Butterest/Blue-Skies-Test-Drone/DronePCB/DronePCB.kicad_pcb

## KiCad design DronePCB/DronePCB.kicad_pcb (2026-11-14)

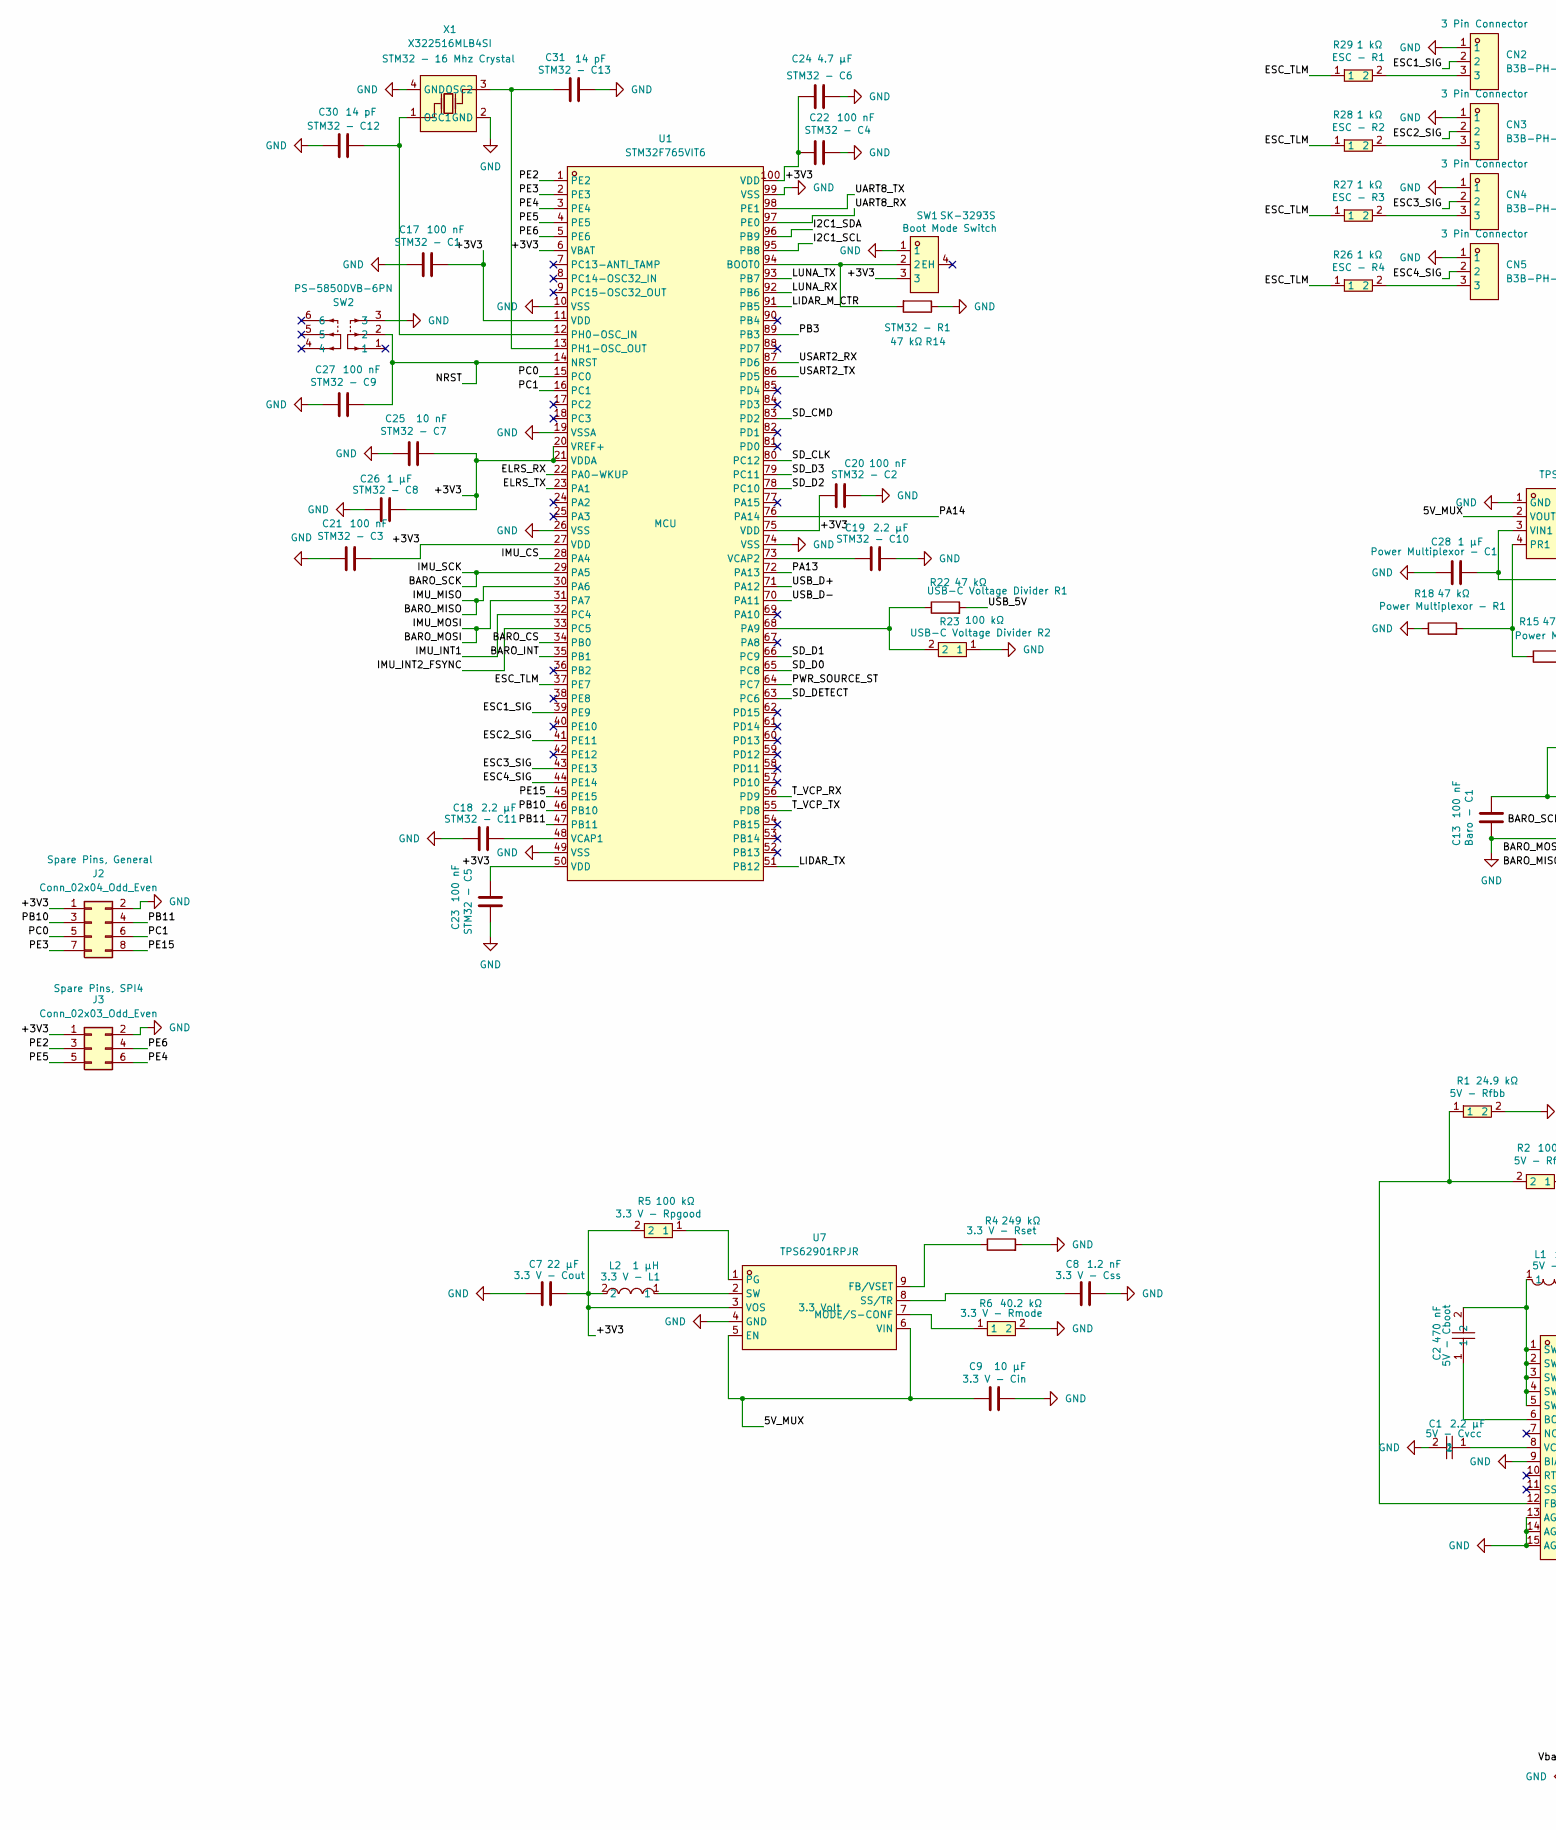
[picture p1: schematic DronePCB.kicad_sch, part in row 1, column 1]

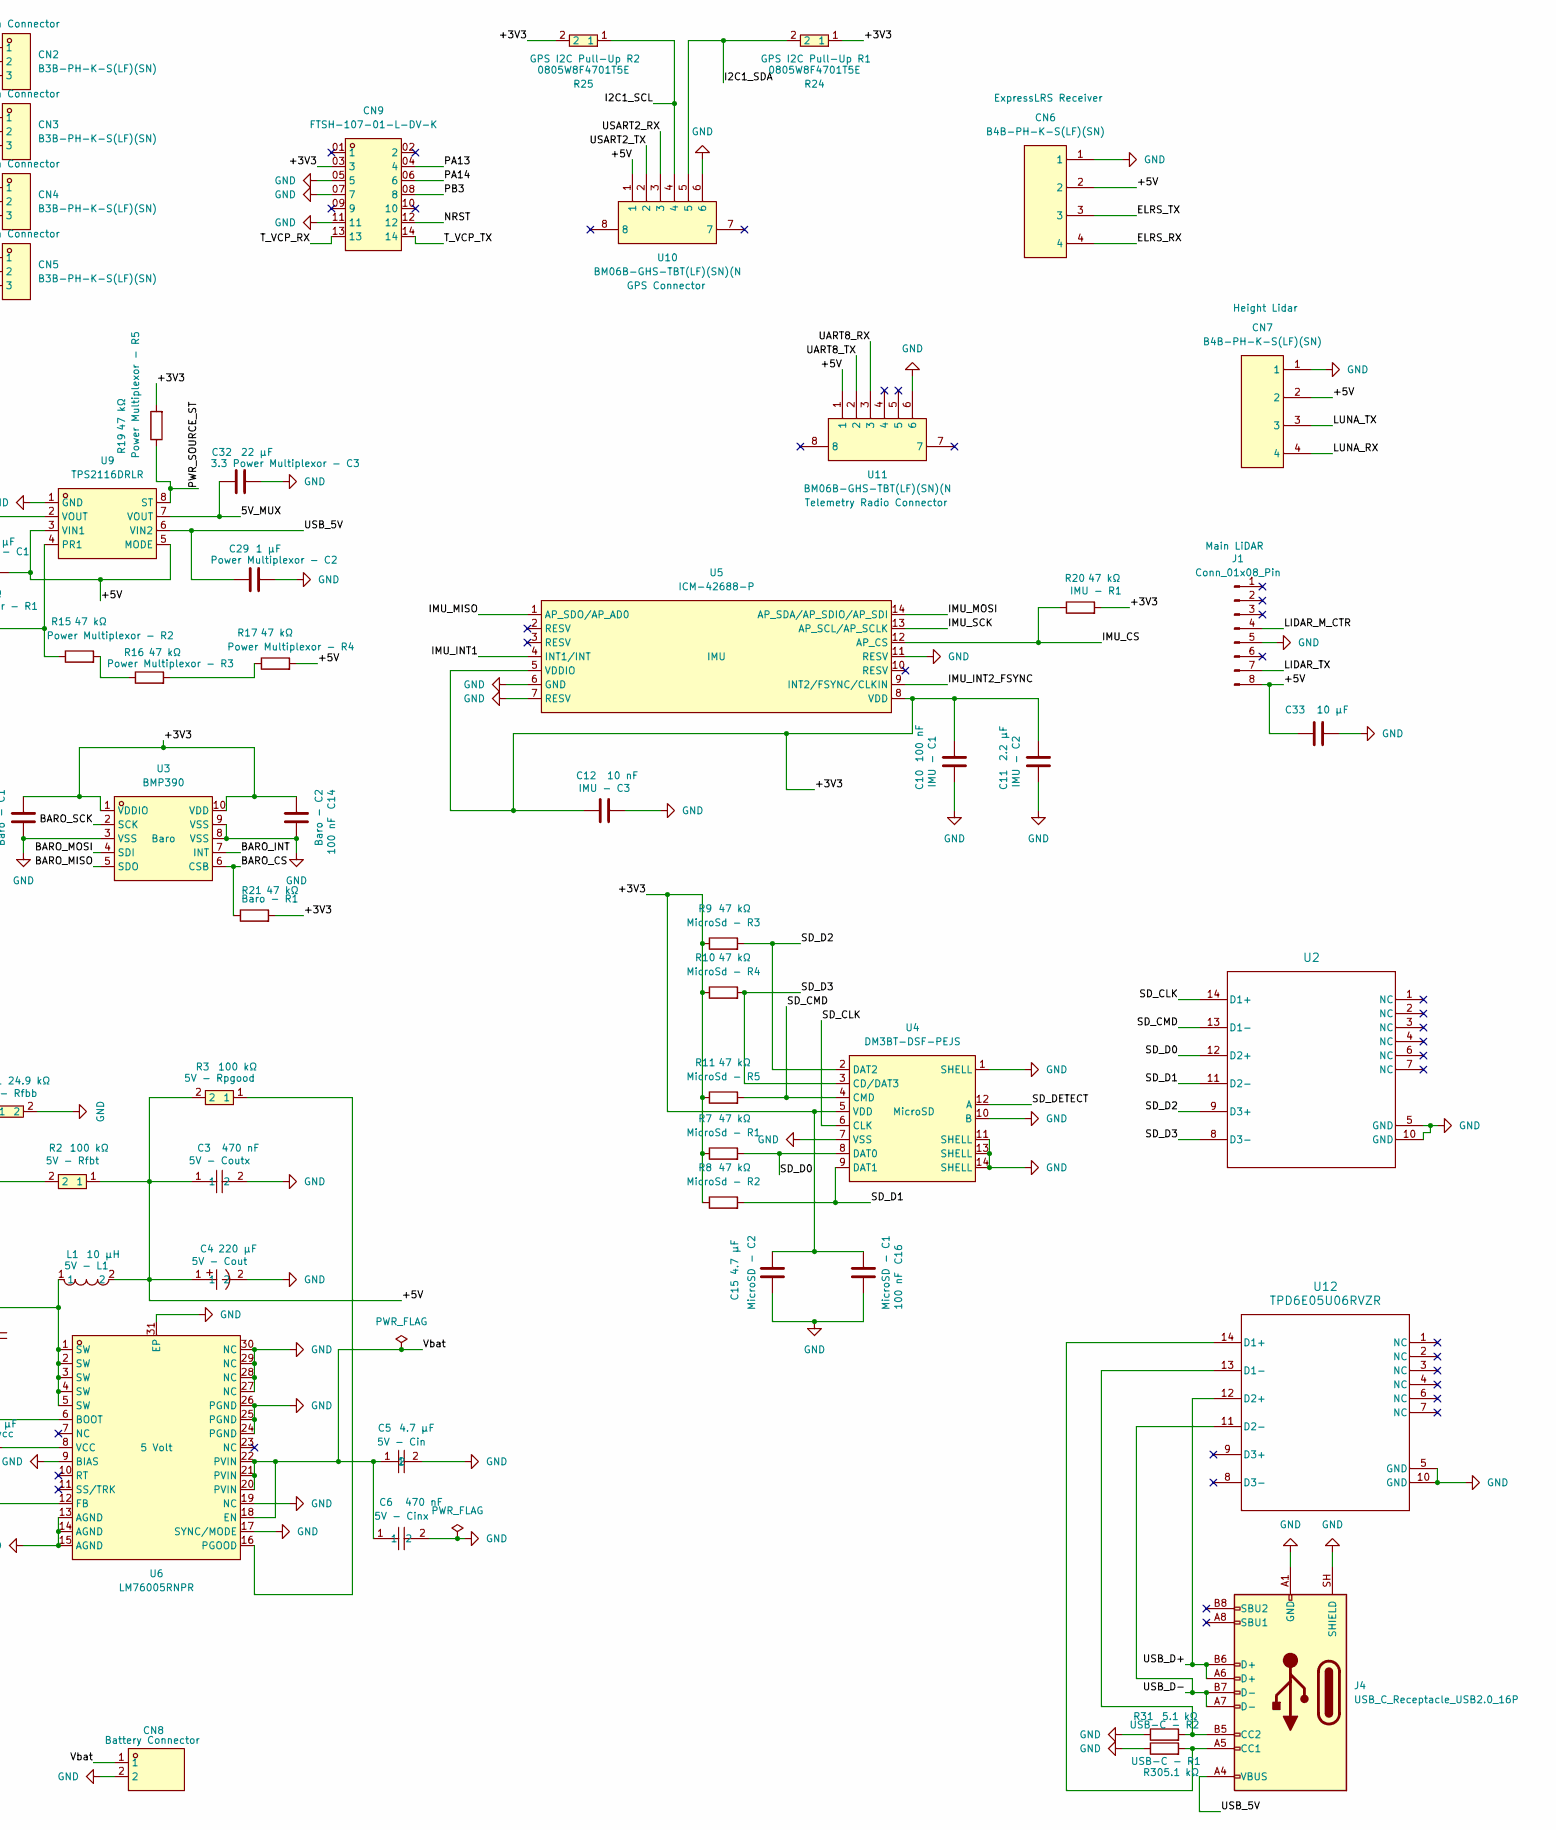
[picture p2: schematic DronePCB.kicad_sch, part in row 1, column 2]

Parts:
C1, C18, C19: 2.2 µF; C_0603_1608Metric; Manufacturer Part # CL10A225KO8NNNC; LCSC Part C23630
C2: 470 nF; C_0402_1005Metric; Manufacturer Part # GRM155R61A474KE15D; LCSC Part C77003
C3: 470 nF; C_0805_2012Metric; Manufacturer Part # EMF212B7474KGHT; LCSC Part C651004
C4: 220 µF; CAP-SMD_L7.3-W4.3; Manufacturer Part # 593D227X0010E2TE3; LCSC Part C1952898
C5, C15, C24: 4.7 µF; C_1206_3216Metric; Manufacturer Part # GRM31CR71H475KA12L; LCSC Part C77096
C6: 470 nF; C_0805_2012Metric; Manufacturer Part # CGA4J3X7R1H474K125AB; LCSC Part C3899838
C7, C32: 22 µF; C_0805_2012Metric; Manufacturer Part # MSASE21GBB5226MTNA01; LCSC Part C140602
C8: 1.2 nF; C_0603_1608Metric; Manufacturer Part # GRM1885C1H122JA01D; LCSC Part C97876
C9, C33: 10 µF; C_0805_2012Metric; Manufacturer Part # MSASE21GAB5106KTNA01; LCSC Part C6684487
C10, C13, C14, C16, C17, C20, C21, C22, C23, C27: 100 nF; C_0402_1005Metric; MPN CL05B104KO5NNNC; LCSC Part C1525
C11: 2.2 µF; C_0805_2012Metric; MPN CL05B104KO5NNNC; LCSC Part C125847
C12, C25: 10 nF; C_0402_1005Metric; MPN CL05B104KO5NNNC; LCSC Part C1524
C26, C28, C29: 1 µF; C_0603_1608Metric; LCSC Part C5199872
C30, C31: 14 pF; C_0402_1005Metric; MPN 0402CG140J500NT; LCSC Part C3037644
CN2, CN3, CN4, CN5: B3B-PH-K-S(LF)(SN); JST_PH_B3B-PH-K_1x03_P2.00mm_Vertical; LCSC Part C131339
CN6, CN7: B4B-PH-K-S(LF)(SN); JST_PH_B4B-PH-K_1x04_P2.00mm_Vertical; LCSC Part C131334
CN8: B2P-VH (LF)(SN); CONN-TH_B2P-VH-LF-SN; MPN B2P-VH (LF)(SN); LCSC Part C160315
CN9: FTSH-107-01-L-DV-K; HDR-SMD_14P-P1.27_FTSH-107-01-L-DV-K; LCSC Part C5307809
J1: Conn_01x08_Pin; JST_PH_B8B-PH-K_1x08_P2.00mm_Vertical; LCSC Part C594302
J2: Conn_02x04_Odd_Even; PinHeader_2x04_P2.54mm_Vertical
J3: Conn_02x03_Odd_Even; PinHeader_2x03_P2.54mm_Vertical
J4: USB_C_Receptacle_USB2.0_16P; USB_C_Receptacle_HRO_TYPE-C-31-M-12; LCSC Part C165948
L1: 10 µH; IND-SMD_L10.2-W10.2-LS10.8; Manufacturer Part # IHLP4040DZER100M01; LCSC Part C845065
L2: 1 µH; L0806; Manufacturer Part # DFE201610E-1R0M=P2; LCSC Part C161082
R1: 24.9 kΩ; R_0603_1608Metric; Manufacturer Part # RC0603FR-0724K9L; LCSC Part C137761
R2, R5, R23: 100 kΩ; R_0402_1005Metric; Manufacturer Part # CRCW0402100KFKED; LCSC Part C481918
R3: 100 kΩ; R_0603_1608Metric; Manufacturer Part # CRCW0603100KFKEA; LCSC Part C844916
R4: 249 kΩ; R_0402_1005Metric; Manufacturer Part Number CRCW0402249KFKEDC; LCSC Part C3009708
R6: 40.2 kΩ; R_0402_1005Metric; Manufacturer Part # CRCW040240K2FKED; LCSC Part C844507
R7, R8, R9, R10, R11, R14, R15, R16, R17, R18, R19, R20, R21, R22: 47 kΩ; R_0805_2012Metric; LCSC Part C17713
R24, R25: 0805W8F4701T5E; R_0805_2012Metric; LCSC Part C17673
R26, R27, R28, R29: 1 kΩ; R_1206_3216Metric; MPN 1206W4J0102T5E; LCSC Part C1469
R30, R31: 5.1 kΩ; R_0805_2012Metric; MPN RESI PTFR0805B5K10P9; LCSC Part C2692693
SW1: SK-3293S; SW-SMD_SK-3293S; LCSC Part C466006
SW2: PS-5850DVB-6PN; SW-TH_6P-L5.8-W5.8-P2.00-LS4.5-BL_1; LCSC Part C5362623
U1: STM32F765VIT6; LQFP-100_L14.0-W14.0-P0.50-LS16.0-BL; LCSC Part C710319
U2, U12: TPD6E05U06RVZR; RVZ0014A; LCSC Part C962978
U3: BMP390; LGA-10_L2.0-W2.0-P0.50-BL; LCSC Part C5124834
U4: DM3BT-DSF-PEJS; SIM-SMD_DM3BT-DSF-PEJS; LCSC Part C597972
U5: ICM-42688-P; LGA-14_L3.0-W2.5-P0.50-TL; LCSC Part C1850418
U6: LM76005RNPR; WQFN-30_L6.0-W4.0-P0.50-TL-EP_LM76005RNPR; LCSC Part C2866241
U7: TPS62901RPJR; VQFN-HR-9_L2.0-W1.5-P0.50-BL_TI_RPJ; LCSC Part C2864847
U9: TPS2116DRLR; SOT-583-8_L2.1-W1.6-P0.50-LS1.6-BL; LCSC Part C3235557
U10, U11: BM06B-GHS-TBT(LF)(SN)(N; CONN-SMD_6P-P1.25_BM06B-GHS-TBT-LF-SN-N; LCSC Part C189892
X1: X322516MLB4SI; CRYSTAL-SMD_4P-L3.2-W2.5-BL; LCSC Part C13738

Connections:
/5V_MUX: C9.1, C32.2, U7.5 (EN), U7.6 (VIN), U9.2 (VOUT), U9.7 (VOUT)
/+3V3: C7.1, C10.2, C11.2, C12.1, C13.2, C14.1, C15.2, C16.1, C17.2, C20.1, C21.2, C22.1, C23.2, C24.1, C25.2, C26.2, CN9.03 (3), J2.1, J3.1, L2.2, R5.2, R7.1, R8.1, R9.1, R10.1, R11.1, R19.2, R20.2, R21.2, R24.1, R25.2, SW1.3, U1.6 (VBAT), U1.11 (VDD), U1.20 (VREF+), U1.21 (VDDA), U1.27 (VDD), U1.50 (VDD), U1.75 (VDD), U1.100 (VDD), U3.1 (VDDIO), U3.10 (VDD), U4.5 (VDD), U5.5 (VDDIO), U5.8 (VDD), U7.3 (VOS)
/+5V: C3.1, C4.1, C28.2, C33.1, CN6.2, CN7.2, J1.8, L1.2, R2.1, R3.2, R17.2, U9.3 (VIN1), U9.5 (MODE), U10.1, U11.1
/BARO_CS: R21.1, U1.34 (PB0), U3.6 (CSB)
/BARO_INT: U1.35 (PB1), U3.7 (INT)
/BARO_MISO: U1.30 (PA6), U3.5 (SDO), U5.1 (AP_SDO/AP_AD0)
/BARO_MOSI: U1.31 (PA7), U3.4 (SDI), U5.14 (AP_SDA/AP_SDIO/AP_SDI)
/BARO_SCK: U1.29 (PA5), U3.2 (SCK), U5.13 (AP_SCL/AP_SCLK)
/ELRS_RX: CN6.4, U1.22 (PA0-WKUP)
/ELRS_TX: CN6.3, U1.23 (PA1)
/ESC1_SIG: CN2.2, U1.39 (PE9)
/ESC2_SIG: CN3.2, U1.41 (PE11)
/ESC3_SIG: CN4.2, U1.43 (PE13)
/ESC4_SIG: CN5.2, U1.44 (PE14)
/ESC_TLM: R26.1, R27.1, R28.1, R29.1, U1.37 (PE7)
/I2C1_SCL: R25.1, U1.95 (PB8), U10.4
/I2C1_SDA: R24.2, U1.96 (PB9), U10.5
/IMU_CS: R20.1, U1.28 (PA4), U5.12 (AP_CS)
/IMU_INT1: U1.32 (PC4), U5.4 (INT1/INT)
/IMU_INT2_FSYNC: U1.33 (PC5), U5.9 (INT2/FSYNC/CLKIN)
/LIDAR_M_CTR: J1.4, U1.91 (PB5)
/LIDAR_TX: J1.7, U1.51 (PB12)
/LUNA_RX: CN7.4, U1.92 (PB6)
/LUNA_TX: CN7.3, U1.93 (PB7)
/NRST: C27.2, CN9.12, SW2.2, U1.14 (NRST)
/PA13: CN9.04 (4), U1.72 (PA13)
/PA14: CN9.06 (6), U1.76 (PA14)
/PB3: CN9.08 (8), U1.89 (PB3)
/PB10: J2.3, U1.46 (PB10)
/PB11: J2.4, U1.47 (PB11)
/PC0: J2.5, U1.15 (PC0)
/PC1: J2.6, U1.16 (PC1)
/PE2: J3.3, U1.1 (PE2)
/PE3: J2.7, U1.2 (PE3)
/PE4: J3.6, U1.3 (PE4)
/PE5: J3.5, U1.4 (PE5)
/PE6: J3.4, U1.5 (PE6)
/PE15: J2.8, U1.45 (PE15)
/PWR_SOURCE_ST: R19.1, U1.64 (PC7), U9.8 (ST)
/SD_CLK: U1.80 (PC12), U2.14 (D1+), U4.6 (CLK)
/SD_CMD: R11.2, U1.83 (PD2), U2.13 (D1-), U4.4 (CMD)
/SD_D0: R7.2, U1.65 (PC8), U2.12 (D2+), U4.8 (DAT0)
/SD_D1: R8.2, U1.66 (PC9), U2.11 (D2-), U4.9 (DAT1)
/SD_D2: R9.2, U1.78 (PC10), U2.9 (D3+), U4.2 (DAT2)
/SD_D3: R10.2, U1.79 (PC11), U2.8 (D3-), U4.3 (CD/DAT3)
/SD_DETECT: U1.63 (PC6), U4.12 (A)
/T_VCP_RX: CN9.13, U1.56 (PD9)
/T_VCP_TX: CN9.14, U1.55 (PD8)
/UART8_RX: U1.97 (PE0), U11.3
/UART8_TX: U1.98 (PE1), U11.2
/USART2_RX: U1.87 (PD6), U10.3
/USART2_TX: U1.86 (PD5), U10.2
/USB_5V: C29.1, J4.A4 (VBUS), J4.A9 (VBUS), J4.B4 (VBUS), J4.B9 (VBUS), R22.2, U9.6 (VIN2)
/USB_D+: J4.A6 (D+), J4.B6 (D+), U1.71 (PA12), U12.12 (D2+)
/USB_D-: J4.A7 (D-), J4.B7 (D-), U1.70 (PA11), U12.11 (D2-)
/Vbat: C5.1, C6.1, CN8.1, U6.18 (EN), U6.20 (PVIN), U6.21 (PVIN), U6.22 (PVIN)
GND: C1.2, C3.2, C4.2, C5.2, C6.2, C7.2, C8.2, C9.2, C10.1, C11.1, C12.2, C13.1, C14.2, C15.1, C16.2, C17.1, C18.1, C19.2, C20.2, C21.1, C22.2, C23.1, C24.2, C25.1, C26.1, C27.1, C28.1, C29.2, C30.1, C31.2, C32.1, C33.2, CN2.1, CN3.1, CN4.1, CN5.1, CN6.1, CN7.1, CN8.2, CN9.05 (5), CN9.07 (7), CN9.11, J1.5, J2.2, J3.2, J4.A1 (GND), J4.A12 (GND), J4.B1 (GND), J4.B12 (GND), J4.SH (SHIELD), R1.2, R4.2, R6.2, R14.1, R18.1, R23.1, R30.1, R31.1, SW1.1, SW2.3, U1.10 (VSS), U1.19 (VSSA), U1.26 (VSS), U1.49 (VSS), U1.74 (VSS), U1.99 (VSS), U2.5 (GND), U2.10 (GND), U3.3 (VSS), U3.8 (VSS), U3.9 (VSS), U4.1 (SHELL), U4.7 (VSS), U4.10 (B), U4.11 (SHELL), U4.13 (SHELL), U4.14 (SHELL), U5.6 (GND), U5.7 (RESV), U5.11 (RESV), U6.9 (BIAS), U6.13 (AGND), U6.14 (AGND), U6.15 (AGND), U6.17 (SYNC/MODE), U6.19 (NC), U6.24 (PGND), U6.25 (PGND), U6.26 (PGND), U6.27 (NC), U6.28 (NC), U6.29 (NC), U6.30 (NC), U6.31 (EP), U7.4 (GND), U9.1 (GND), U10.6, U11.6, U12.5 (GND), U12.10 (GND), X1.2 (GND), X1.4 (GND)
unnamed: C2.2, L1.1, U6.1 (SW), U6.2 (SW), U6.3 (SW), U6.4 (SW), U6.5 (SW)
unnamed: CN2.3, R29.2
unnamed: CN3.3, R28.2
unnamed: CN4.3, R27.2
unnamed: CN5.3, R26.2
unnamed: J4.A5 (CC1), R30.2, U12.14 (D1+)
unnamed: J4.B5 (CC2), R31.2, U12.13 (D1-)
unnamed: R15.2, R16.1
unnamed: R16.2, R17.1
unnamed: R14.2, SW1.2, U1.94 (BOOT0)
unnamed: R22.1, R23.2, U1.68 (PA9)
unnamed: C30.2, U1.12 (PH0-OSC_IN), X1.1 (OSC1)
unnamed: C31.1, U1.13 (PH1-OSC_OUT), X1.3 (OSC2)
unnamed: C18.2, U1.48 (VCAP1)
unnamed: C19.1, U1.73 (VCAP2)
unnamed: C2.1, U6.6 (BOOT)
unnamed: R1.1, R2.2, U6.12 (FB)
unnamed: R3.1, U6.16 (PGOOD)
unnamed: C1.1, U6.8 (VCC)
unnamed: R4.1, U7.9 (FB/VSET)
unnamed: R6.1, U7.7 (MODE/S-CONF)
unnamed: R5.1, U7.1 (PG)
unnamed: C8.1, U7.8 (SS/TR)
unnamed: L2.1, U7.2 (SW)
unnamed: R15.1, R18.2, U9.4 (PR1)

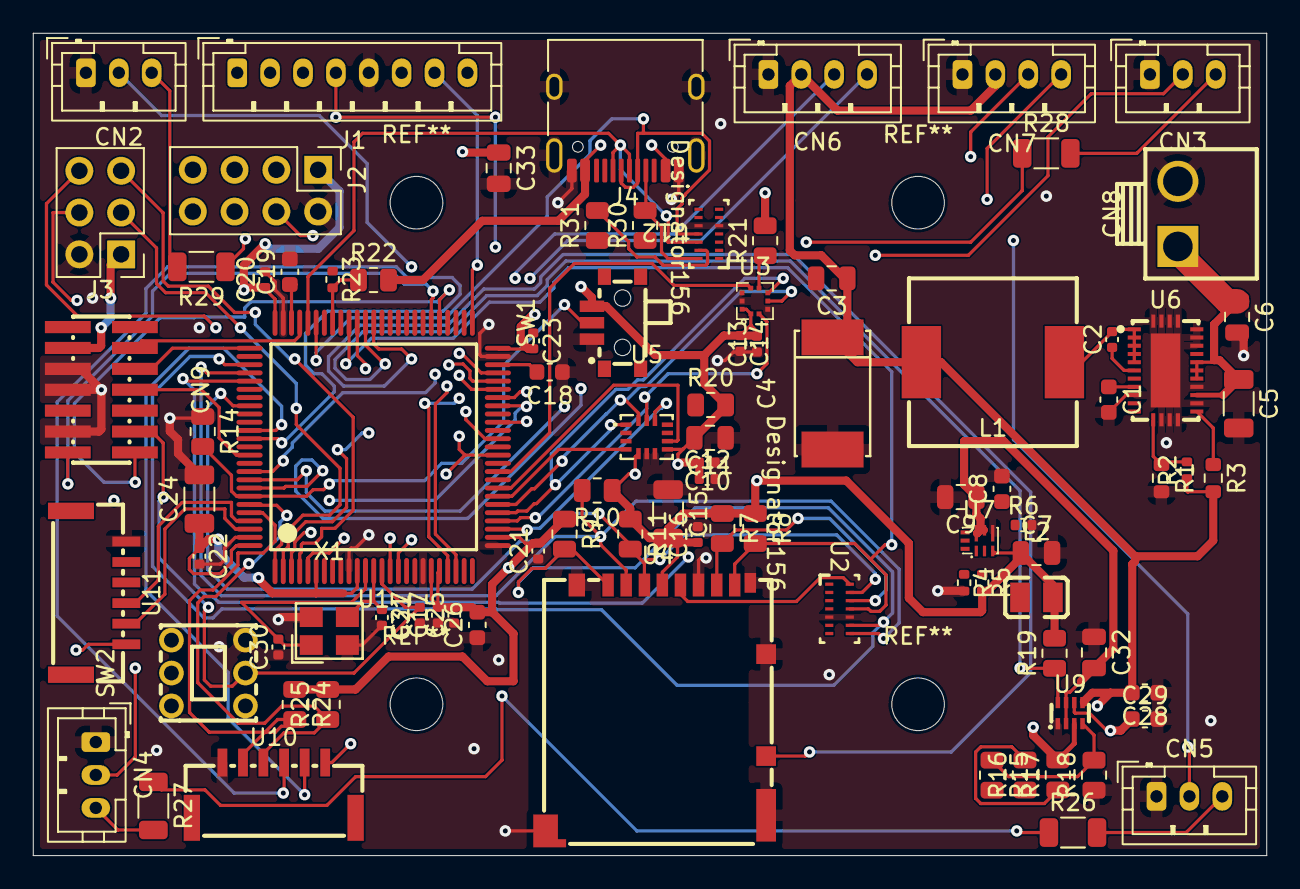
[picture p3: board DronePCB.kicad_pcb from above]

Board: 4 copper layers, 75.0 x 50.0 mm, 90 parts (0 on the bottom side), 82 nets.
