Butterest/Blue-Skies-Test-Drone/(commit log)

2026-11-04 Initial Commit
    Initial Commit
    [DronePCB.kicad_pcb, DronePCB.kicad_sch]
2026-11-05 Supporting Circuitry Done
    [DronePCB.kicad_sch]
2026-11-05 Surface Mounted Components wired entirely. Next is finding/designing mounts for external components.
    [DronePCB.kicad_sch]
2026-11-07 PCB Started
    [DronePCB.kicad_pcb]
2026-11-09 Some External Components integrated.
    [DronePCB.kicad_pcb, DronePCB.kicad_sch]
2026-11-09 GPS finalized, some 3d model cleanup
    [DronePCB.kicad_pcb, DronePCB.kicad_sch]
2026-11-09 Schematic Finished
    [DronePCB.kicad_pcb, DronePCB.kicad_sch]
2026-11-09 Footprint qualms squashed, just pcb placement and routing remains, constraints implemented for jlcpcb, but should be verified with up to date constraints
    [DronePCB.kicad_pcb, DronePCB.kicad_sch]
2026-11-10 Main components placed on board
    [DronePCB.kicad_pcb, DronePCB.kicad_sch]
2026-11-10 All components on pcb and organized(First Draft)
    [DronePCB.kicad_pcb]
2026-11-11 Component alignment adjustments, some components need revised footprints(for courtyards)
    [DronePCB.kicad_pcb]
2026-11-11 Im tired I dont remember what ive changed
    [DronePCB.kicad_pcb, DronePCB.kicad_sch]
2026-11-13 Placement done, just need to resolve ST-Link connector clearance
    [DronePCB.kicad_pcb]
2026-11-13 Routing halfway done
    [DronePCB.kicad_pcb, DronePCB.kicad_sch]
2026-11-14 Routing done, just need to verify everything is good, then PCB is done
    [DronePCB.kicad_pcb]
